Michal-Md/PUEiE/IoT.pdf

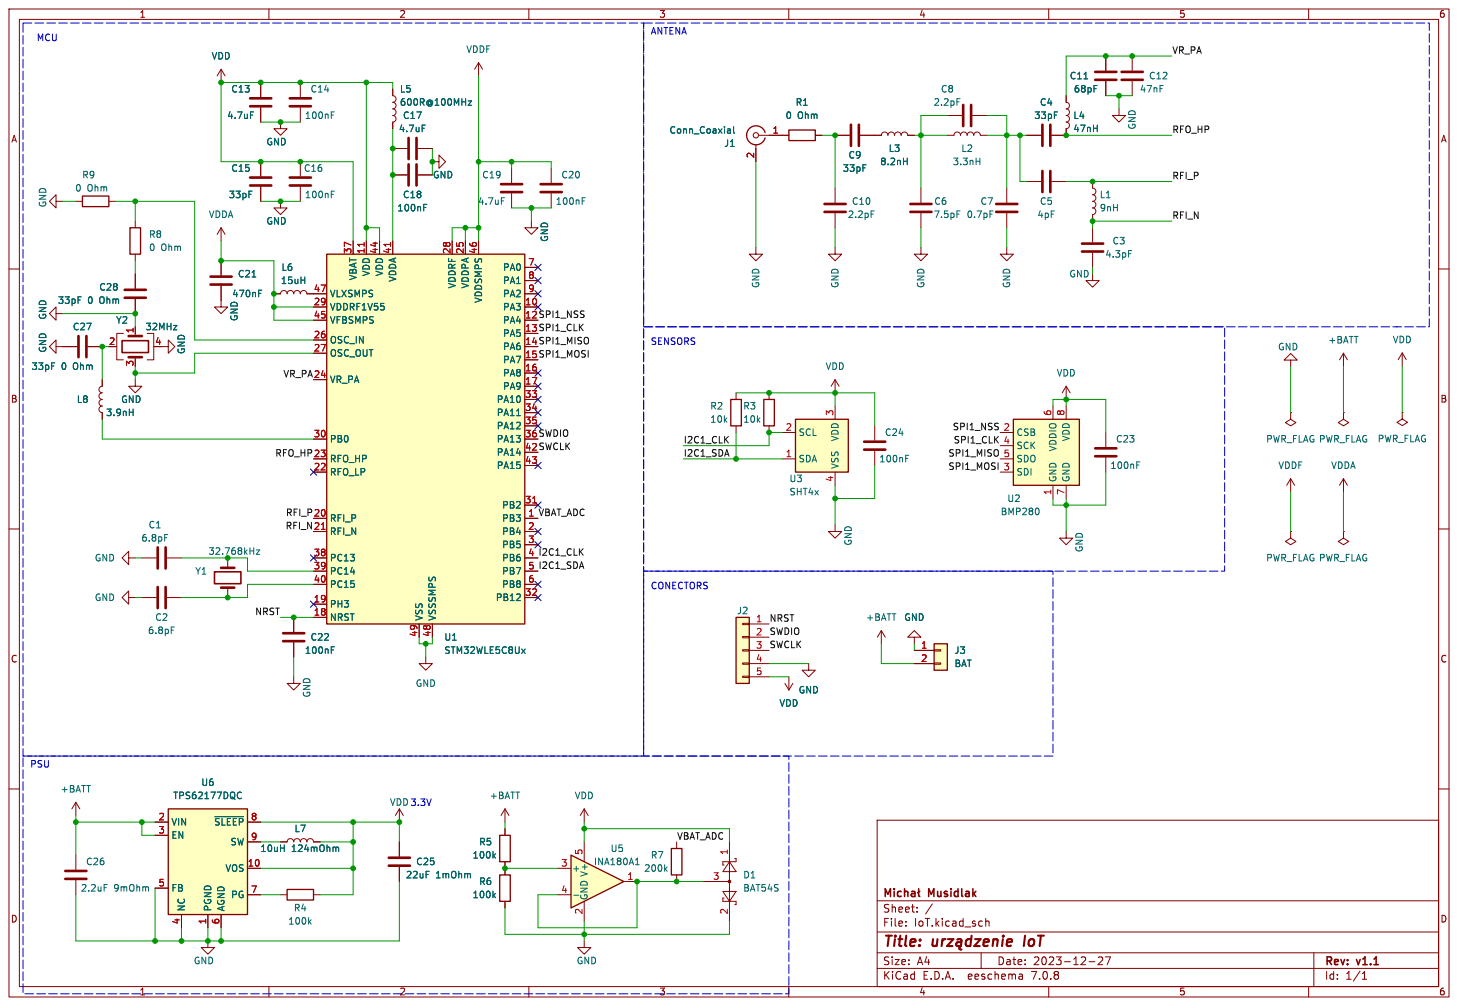
[picture p1: page 1]

1 CSB 2 SDI 3 SCK 4 SDO 5 VDDIO

6 PG 7 ~{SLEEP}8 SW 9 U6 TPS62177DQC GND

PSU
U6 TPS62177DQC PGND
File: IoT.kicad_sch Sheet: / þÿMichaB Musidlak VDD GND

1 VOS 10 VIN 2 EN 3 NC

Id: 1/1 Title: þÿurzdzenie IoT
