Michal-Md/PUEiE/IoT.kicad_pcb

## KiCad design IoT.kicad_pcb (2024-01-01)

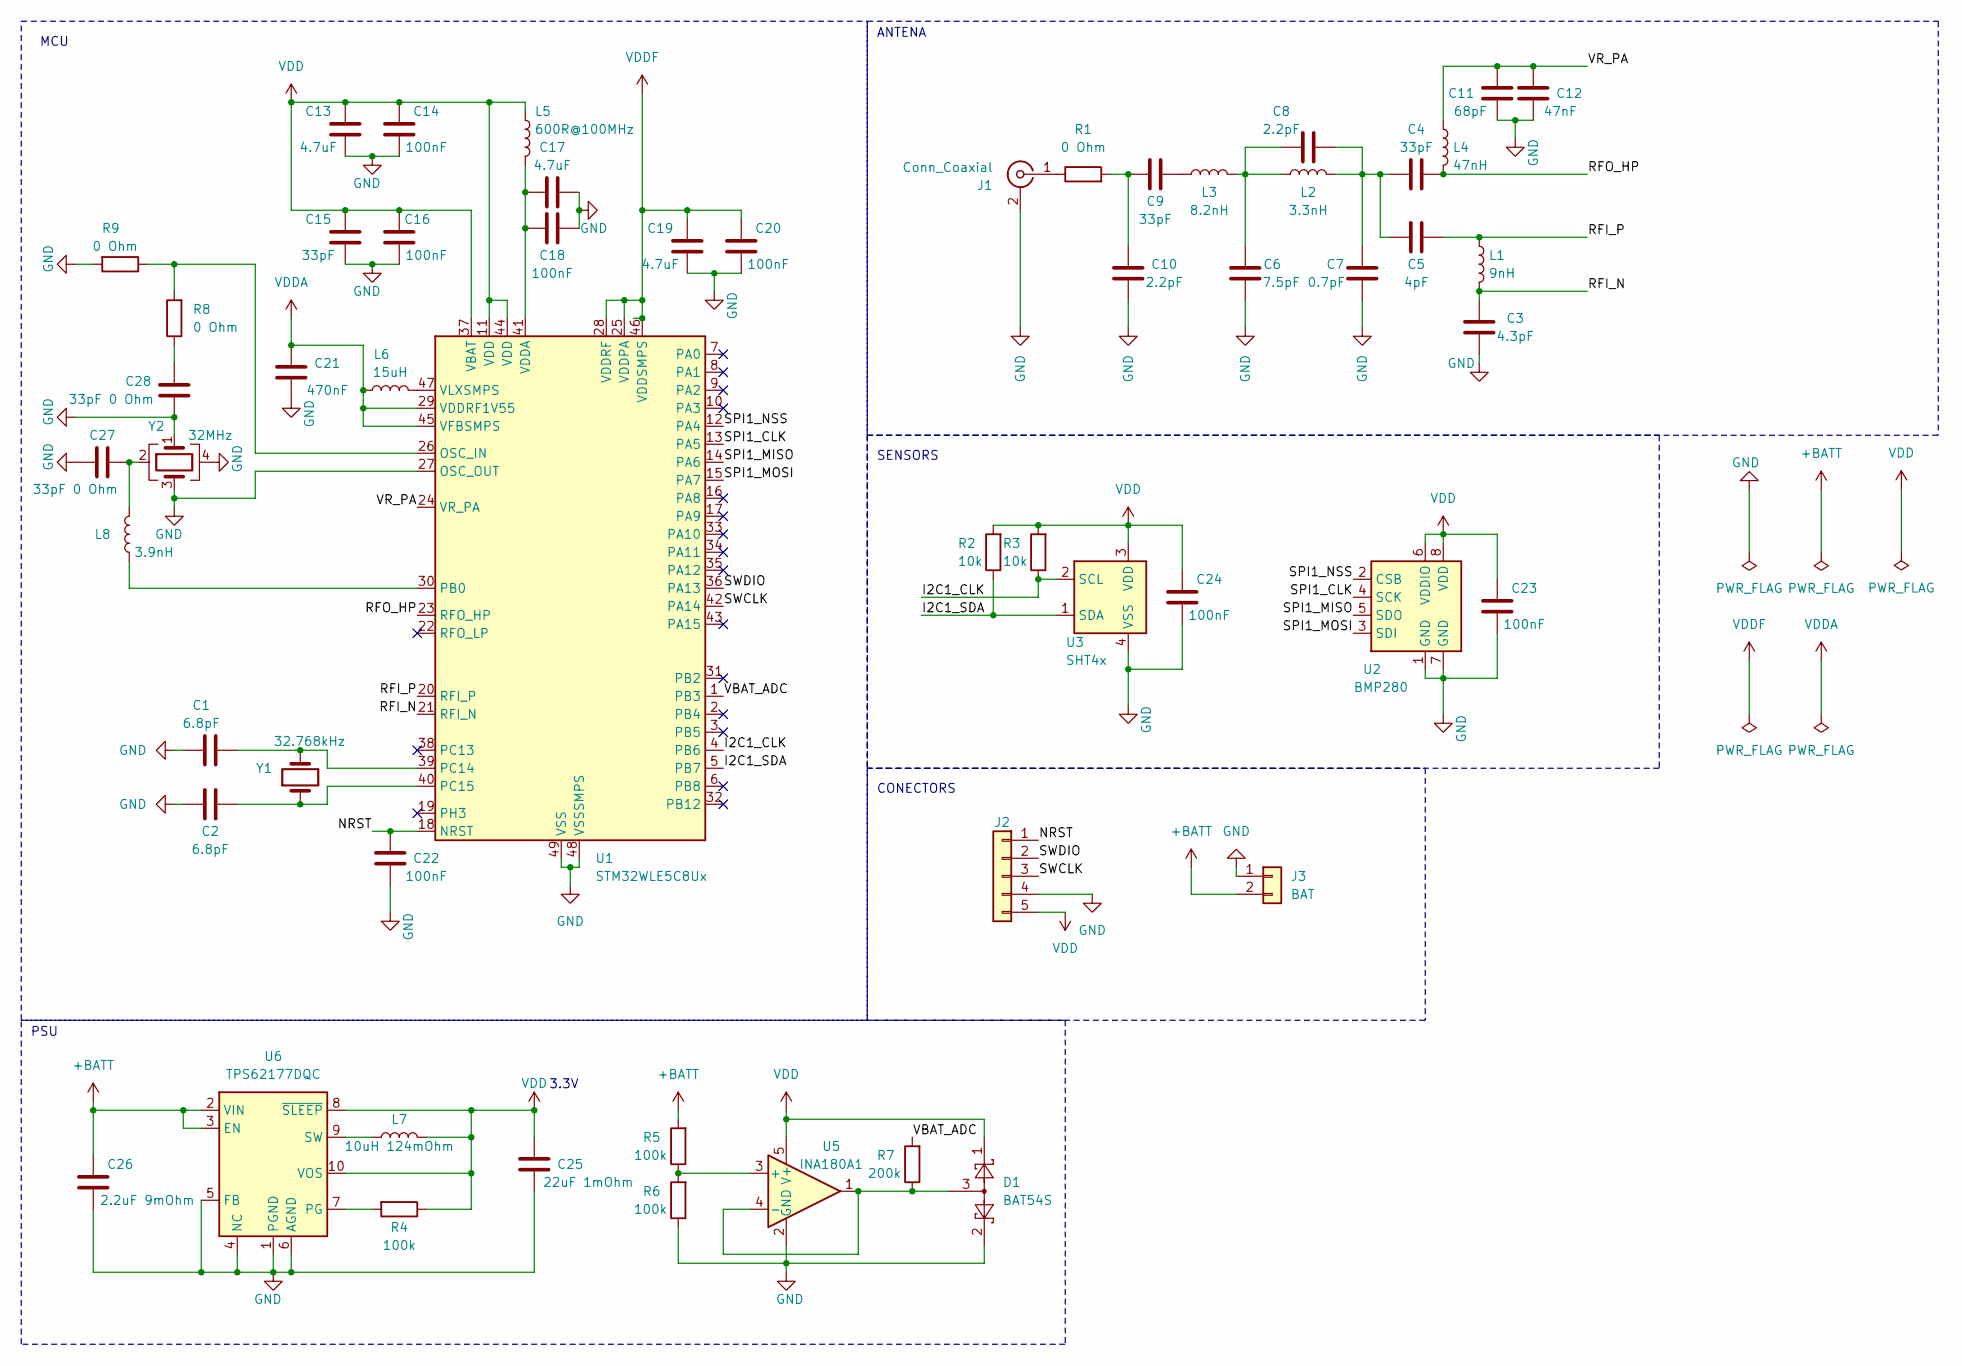
[picture p2: schematic IoT.kicad_sch, urządzenie IoT]

Parts:
C1, C2: 6.8pF; C_0603_1608Metric_Pad1.08x0.95mm_HandSolder
C3: 4.3pF; C_0603_1608Metric_Pad1.08x0.95mm_HandSolder
C4, C9, C15: 33pF; C_0603_1608Metric_Pad1.08x0.95mm_HandSolder
C5: 4pF; C_0603_1608Metric_Pad1.08x0.95mm_HandSolder
C6: 7.5pF; C_0603_1608Metric_Pad1.08x0.95mm_HandSolder
C7: 0.7pF; C_0603_1608Metric_Pad1.08x0.95mm_HandSolder
C8, C10: 2.2pF; C_0603_1608Metric_Pad1.08x0.95mm_HandSolder
C11: 68pF; C_0603_1608Metric_Pad1.08x0.95mm_HandSolder
C12: 47nF; C_0603_1608Metric_Pad1.08x0.95mm_HandSolder
C13, C17, C19: 4.7uF; C_0603_1608Metric_Pad1.08x0.95mm_HandSolder
C14, C16, C18, C20, C22, C23, C24: 100nF; C_0603_1608Metric_Pad1.08x0.95mm_HandSolder
C21: 470nF; C_0603_1608Metric_Pad1.08x0.95mm_HandSolder
C25: 22uF 1mOhm; C_0603_1608Metric_Pad1.08x0.95mm_HandSolder
C26: 2.2uF 9mOhm; C_0603_1608Metric_Pad1.08x0.95mm_HandSolder
C27, C28: 33pF 0 Ohm; C_0603_1608Metric_Pad1.08x0.95mm_HandSolder
D1: BAT54S; SOT-23
J1: Conn_Coaxial; SMA_Samtec_SMA-J-P-X-ST-EM1_EdgeMount
J2: Conn_01x05; PinHeader_1x05_P2.54mm_Vertical
J3: BAT; TerminalBlock_TE_282834-2_1x02_P2.54mm_Horizontal
L1: 9nH; L_0402_1005Metric_Pad0.77x0.64mm_HandSolder
L2: 3.3nH; L_0402_1005Metric_Pad0.77x0.64mm_HandSolder
L3: 8.2nH; L_0805_2012Metric_Pad1.15x1.40mm_HandSolder
L4: 47nH; L_0402_1005Metric_Pad0.77x0.64mm_HandSolder
L5: 600R@100MHz; L_0603_1608Metric_Pad1.05x0.95mm_HandSolder
L6: 15uH; L_0805_2012Metric_Pad1.15x1.40mm_HandSolder
L7: 10uH 124mOhm; L_TDK_SLF6025
L8: 3.9nH; L_0402_1005Metric_Pad0.77x0.64mm_HandSolder
R1, R8, R9: 0 Ohm; R_0603_1608Metric_Pad0.98x0.95mm_HandSolder
R2, R3: 10k; R_0603_1608Metric_Pad0.98x0.95mm_HandSolder
R4, R5, R6: 100k; R_0603_1608Metric_Pad0.98x0.95mm_HandSolder
R7: 200k; R_0603_1608Metric_Pad0.98x0.95mm_HandSolder
U1: STM32WLE5C8Ux; QFN-48-1EP_7x7mm_P0.5mm_EP5.6x5.6mm
U2: BMP280; Bosch_LGA-8_2x2.5mm_P0.65mm_ClockwisePinNumbering
U3: SHT4x; Sensirion_DFN-4_1.5x1.5mm_P0.8mm_SHT4x_NoCentralPad
U5: INA180A1; SOT-23-5
U6: TPS62177DQC; WSON-10-1EP_2x3mm_P0.5mm_EP0.84x2.4mm_ThermalVias
Y1: 32.768kHz; Crystal_SMD_2012-2Pin_2.0x1.2mm_HandSoldering
Y2: 32MHz; Crystal_SMD_2016-4Pin_2.0x1.6mm

Connections:
+BATT: C26.1, J3.2, R5.2, U6.2 (VIN), U6.3 (EN)
/I2C1_CLK: R3.1, U1.4 (PB6), U3.2 (SCL)
/I2C1_SDA: R2.1, U1.5 (PB7), U3.1 (SDA)
/NRST: C22.1, J2.1, U1.18 (NRST)
/RFI_N: C3.1, L1.2, U1.21 (RFI_N)
/RFI_P: C5.1, L1.1, U1.20 (RFI_P)
/RFO_HP: C4.1, L4.2, U1.23 (RFO_HP)
/SPI1_CLK: U1.13 (PA5), U2.4 (SCK)
/SPI1_MISO: U1.14 (PA6), U2.5 (SDO)
/SPI1_MOSI: U1.15 (PA7), U2.3 (SDI)
/SPI1_NSS: U1.12 (PA4), U2.2 (CSB)
/SWCLK: J2.3, U1.42 (PA14)
/SWDIO: J2.2, U1.36 (PA13)
/VBAT_ADC: R7.2, U1.1 (PB3)
/VR_PA: C11.1, C12.1, L4.1, U1.24 (VR_PA)
GND: C1.2, C2.2, C3.2, C6.2, C7.2, C10.2, C11.2, C12.2, C13.2, C14.2, C15.2, C16.2, C17.2, C18.2, C19.2, C20.2, C21.1, C22.2, C23.2, C24.2, C25.2, C26.2, C27.1, C28.1, D1.2, J1.2 (Ext), J2.4, J3.1, R6.1, R9.2, U1.27 (OSC_OUT), U1.48 (VSSSMPS), U1.49 (VSS), U2.1 (GND), U2.7 (GND), U3.4 (VSS), U5.2 (GND), U6.1 (PGND), U6.4 (NC), U6.5 (FB), U6.6 (AGND), Y2.1, Y2.3, Y2.4
unnamed: C4.2, C5.2, C7.1, C8.1, L2.2
unnamed: C6.1, C8.2, L2.1, L3.2
unnamed: C9.1, L3.1
unnamed: C9.2, C10.1, R1.2
unnamed: C27.2, L8.2, Y2.2
unnamed: C28.2, R8.1
unnamed: J1.1 (In), R1.1
unnamed: R8.2, R9.1, U1.26 (OSC_IN)
unnamed: L8.1, U1.30 (PB0)
unnamed: C1.1, U1.39 (PC14), Y1.2
unnamed: C2.1, U1.40 (PC15), Y1.1
unnamed: C17.1, C18.1, L5.2, U1.41 (VDDA)
unnamed: L6.2, U1.47 (VLXSMPS)
unnamed: R5.1, R6.2, U5.3 (+)
unnamed: D1.3, R7.1, U5.1, U5.4 (-)
unnamed: R4.2, U6.7 (PG)
unnamed: L7.1, U6.9 (SW)
VDD: C13.1, C14.1, C15.1, C16.1, C23.1, C24.1, C25.1, D1.1, J2.5, L5.1, L7.2, R2.2, R3.2, R4.1, U1.11 (VDD), U1.37 (VBAT), U1.44 (VDD), U2.6 (VDDIO), U2.8 (VDD), U3.3 (VDD), U5.5 (V+), U6.8 (~SLEEP), U6.10 (VOS)
VDDA: C21.2, L6.1, U1.29 (VDDRF1V55), U1.45 (VFBSMPS)
VDDF: C19.1, C20.1, U1.25 (VDDPA), U1.28 (VDDRF), U1.46 (VDDSMPS)

Notes on the sheet:
3.3V
PSU
ANTENA
SENSORS
CONECTORS
MCU

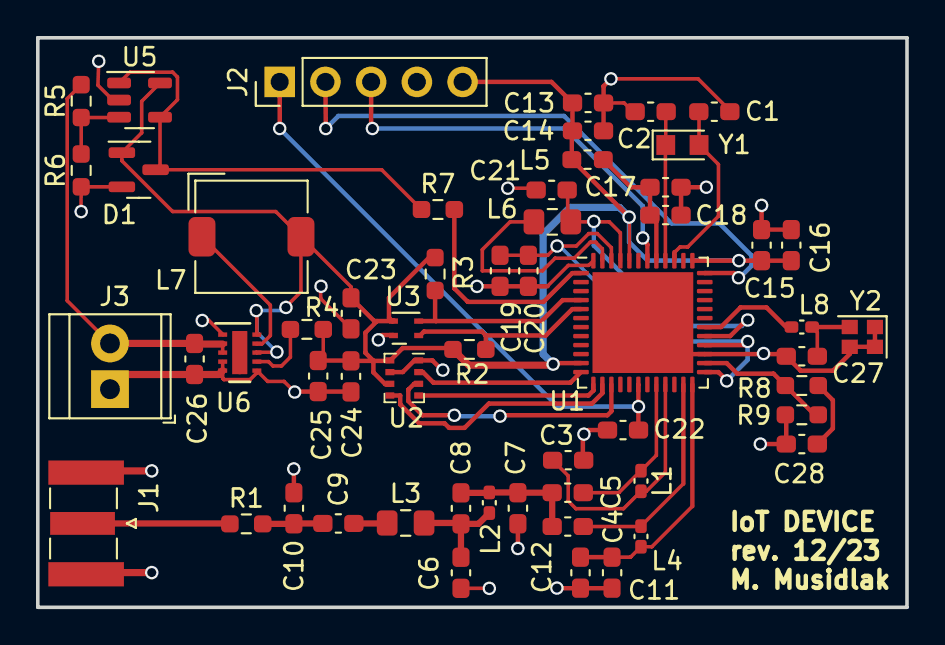
[picture p3: board IoT.kicad_pcb from above]

Board: 2 copper layers, 48.3 x 31.6 mm, 56 parts (0 on the bottom side), 36 nets.
